alphafox02/eSpDR/(commit log)

2026-09-26 Restore the ESP crystal and forward its clock to the FPGA
    Use GPIO41 I2S MCLK at 20 MHz through Br B12/F4 for the acquisition domain. Keep management and DDR independent, latch clock faults, and validate pulse anomalies in host captures.
    Update the wiring diagram, receiver guide, loading instructions and clock-domain documentation. Validate with the ESP/host builds and the full offline test suite.
2026-10-01 Add a one-shot snapshot command for use without the FPGA
    ESP_SNAPSHOT runs the dump engine into capture bank 0 until its ring has
    been overwritten, stops it, and sends the ring over the ESP's USB
    Serial/JTAG port after the normal reply. At 16 Msps that is about 1 ms of a
    16 MHz window per request, which is enough to check reception and decode
    BLE on the host without the Alchitry link.
    usb/snap.py pulls snapshots and writes conjugated, scaled int16 IQ.
    USB.md describes the mode and its limits.
    [control.h, main.c, snap.py, snapshot.c, snapshot.h]
2026-10-01 Stream bursts over USB without the FPGA
    ESP_STREAM watches a 16 MHz window continuously and sends only the
    bursts above the noise floor, timestamped in samples, until the host
    sends a byte.
    Core 1 keeps the dump engine running and rotates it through banks 0, 1
    and 3, preparing each bank with sentinels just before the writer enters
    it and finding the exact first and last pairs once it leaves. A segment
    that is not contiguous with the previous one is reported as a
    discontinuity rather than stitched over. Core 1 also feeds USB, whose
    single 64-byte buffer has to be refilled promptly to avoid NAKs.
    Core 0 detects bursts in 8 us blocks, can drop OFDM-like ones by their
    envelope, and packs the r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
    [capture.c, capture.h, control.h, main.c, stream.c, stream.h]
2026-10-01 Add a stream receiver and document the USB modes
    usb/stream.py starts a stream, checks every record's sequence and check
    value, and writes the bursts as int16 IQ for blue-dragon. snap.py gets a
    write timeout so a busy ESP cannot hang it.
    [snap.py, stream.py]
2026-10-01 Add a vector channel filter and a self-test for it
    narrow_run() mixes eight pairs at a time down by a whole number of MHz,
    filters them to +-1.6 MHz with a 12-tap filter and keeps every fourth,
    using the S3's vector extension: about 8 cycles per pair, where the same
    filter in C took 98.
    ESP_NARROW_TEST runs it over a snapshot and returns the input and output,
    and usb/narrow_check.py checks the output against the same arithmetic in
    numpy for every offset.
2026-10-01 stream: optionally send each burst cut to its own channel
    With ESP_STREAM arg bit 1, each burst's frequency is measured over its
    first 32 us and only its channel is sent, at 4 Msps: a quarter of the
    data, so more bursts fit through USB and the cap rises to 3 ms, enough
    for a whole 3-DH5 packet. With Wi-Fi rejection on, bursts that keep less
    than half their power in their channel are dropped, which catches OFDM
    that the envelope test lets through.
    Pairs are now counted from a multiple of 8 in the ring so that groups of
    eight are aligned for the vector loads. stream.py restores the records
    to 16 Msps with --channelize.
    On a busy band, 45 s live through blue-dragon: 514 BLE packets with a
    val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
2026-10-01 stream: let several receivers share one LO by channel position
    At 16 Msps a receiver hears about 80 MHz around its LO folded into its
    window, so tuning receivers apart does not divide the band between them.
    Instead they can share an LO and split the window's channel positions:
    the high half of the ESP_STREAM argument is a mask of the offsets a
    receiver sends, and channelized bursts outside it are skipped (and
    counted as rejected). stream.py takes the mask as --positions.
    [stream.c, stream.h, stream.py]
2026-10-01 stream: reject Wi-Fi at the window's edge by its envelope
    With the baseband filter narrowed, Wi-Fi only partly inside the window
    can keep enough power in a channel to pass the in-channel power test,
    and was sent as 3 ms channelized bursts that filled the queue. Its power
    still fluctuates like noise in the channel, where Bluetooth's is
    constant, so the burst is also rejected when the power variance left
    after allowing for the channel's noise exceeds 0.15 of the signal power
    squared. Measured: BLE -0.07..0.05 (down to 6 dB SNR), such Wi-Fi
    0.25..0.9. On the two edge-affected windows the USB load fell from 382
    and 538 kB/s to 56 and 10 kB/s.
    USB.md now describes the baseband filter as the only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
    [stream.c]
2026-10-01 stream: stamp status records on common USB frame boundaries
    Receivers tuned to different slices of the band share no signal to align
    their sample clocks on, and USB arrival times are only good to about a
    millisecond. Every device below one USB host sees the same start-of-frame
    numbers, so core 1 now latches the sample count just after each new
    frame, and status records go out on 256-frame boundaries carrying that
    count as their start, with the frame number in their flags (bit 15 marks
    it; older hosts ignore it).
    The frame register is also polled while sentinels are planted, which
    otherwise delays the latch by several microseconds, except during the
    two preparations at start-up, which race t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
2026-10-01 usb: add a tool that loads the firmware into every attached ESP32-S3
    load.py finds each board's USB Serial/JTAG port, loads the image into
    its RAM with esptool and checks that the firmware then answers, so a
    rig of several boards is ready with one command. USB.md describes using
    it with a release image, without building.
2026-10-02 usb: identify ESP devices before loading
2026-10-03 stream: skip the envelope test for channels near the LO
    The radio's DC offset lies inside the filter of channels within 2 MHz of
    the LO and beats with a Bluetooth packet there, so its power fluctuates
    and the in-channel envelope test dropped it as Wi-Fi. Wi-Fi near the LO
    covers the whole window and fails the in-channel power test anyway; the
    envelope test is for Wi-Fi only partly inside, at the window's edges.
    During an l2ping flood with the LO at 2408.5 MHz, the two channels beside
    it went from a median of 59% to 105% of the packets on the farther
    channels, and forwarded bursts rose by about 3%.
    [stream.c]
2026-10-03 stream: keep near-LO Wi-Fi test with wide filter
2026-10-03 Report a firmware revision so hosts can detect outdated boards
    CTL_INFO argument 3 returns the firmware revision, 1 for this firmware.
    Firmware from before revisions answers with CTL_BAD_ARGUMENT, so a host
    can tell it apart and ask for an update. The loader prints each board's
    revision after loading it.
